schmellic/speeduino-dash/docs/speeduino_solder_points.png

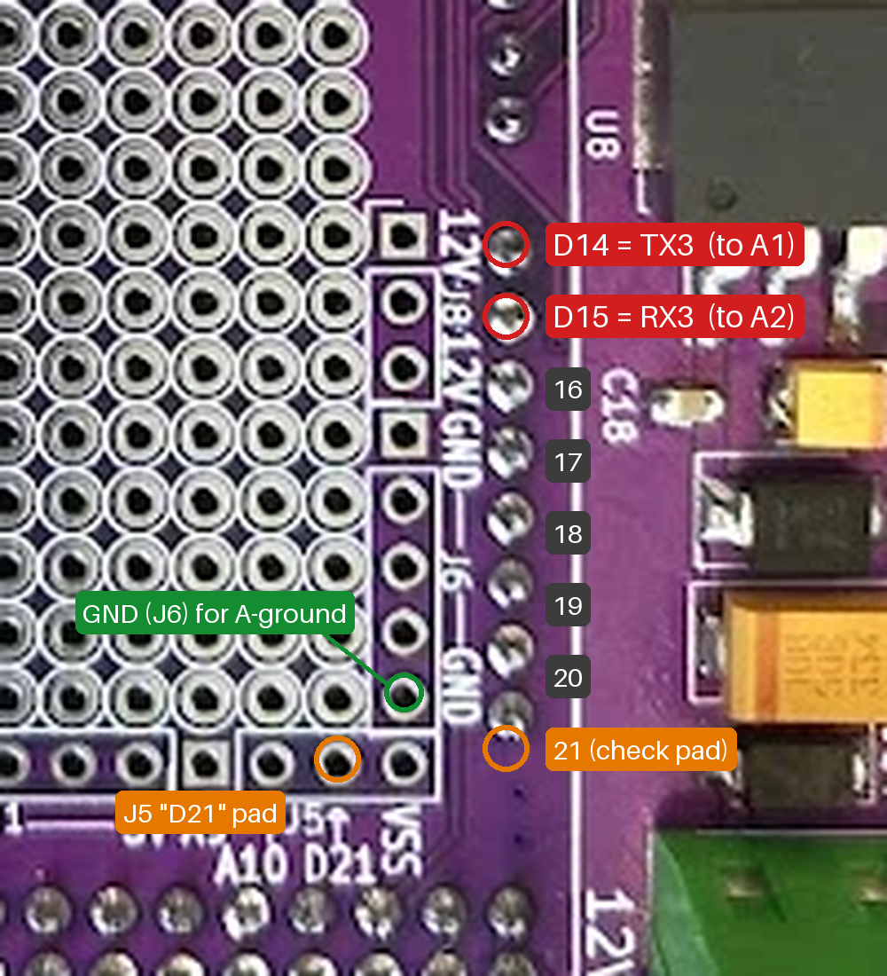
docs/speeduino_solder_points.png
