schmellic/speeduino-dash/docs/bridge_board_labelled.jpg

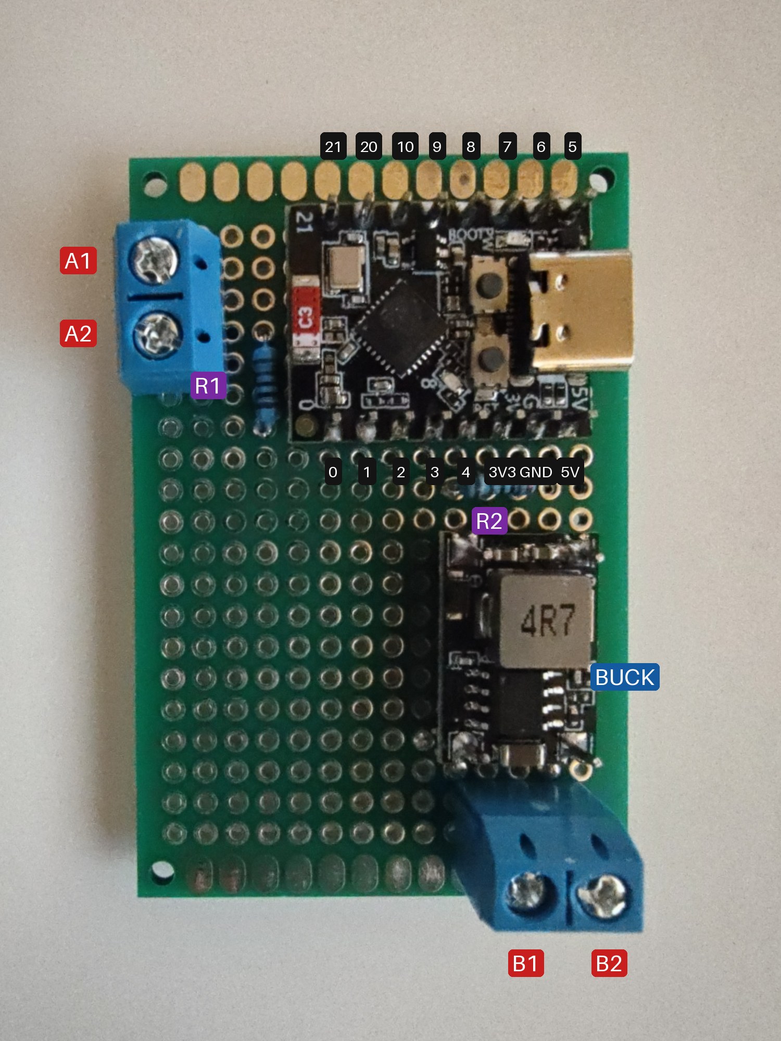
docs/bridge_board_labelled.jpg
