schmellic/speeduino-dash/docs/header_labels.pdf

Dash header labels, print at 100% (no scaling). Pitch 2.54 mm. Top = screen pin, bottom = ESP32 pin (GPIO number).

TACH

VCC 3V3

GND GND
SCL 18

SDA 23
RST 22
DC 21
CS 5
BL 25

INFO

VCC 3V3

GND GND
CS 4

RESET 27
DC 21

SDI 23

SCK 18
LED 26
