schmellic/speeduino-dash/enclosure/stl/bridge_box_lid.stl

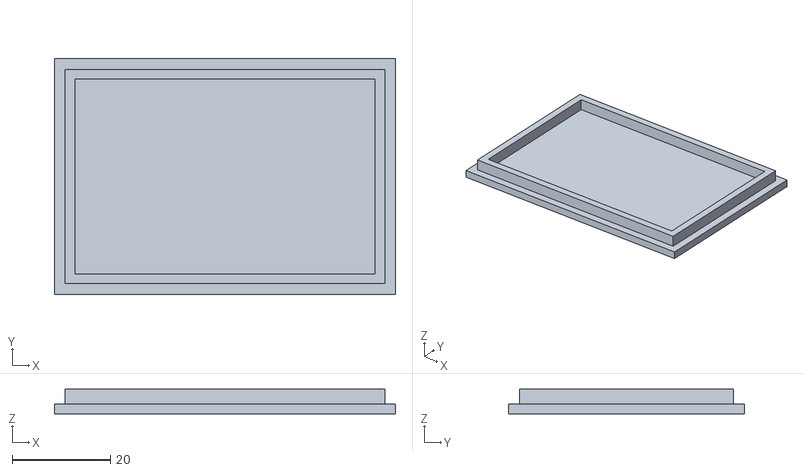
[picture p3: CAD file, 2026-11-03]
enclosure/stl/bridge_box_lid.stl
69.5 x 48.0 x 5.00
