schmellic/speeduino-dash/enclosure/stl/bridge_box_base.stl

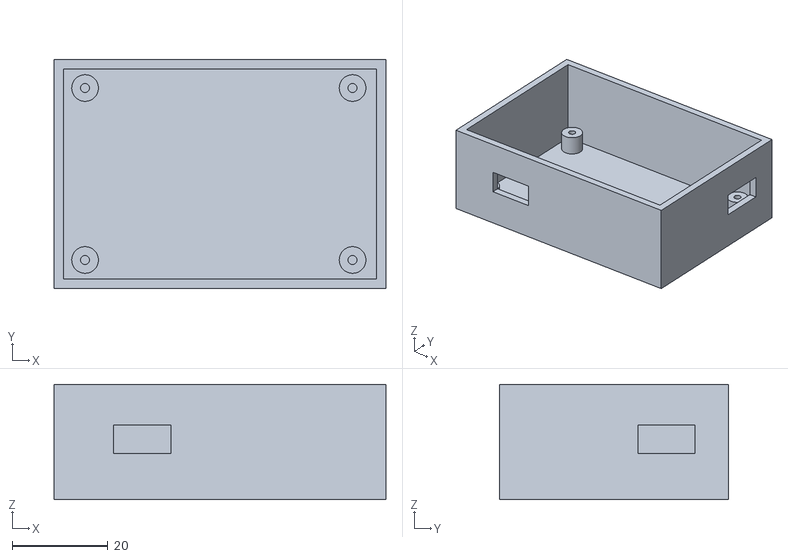
[picture p4: CAD file, 2026-11-03]
enclosure/stl/bridge_box_base.stl
69.5 x 48.0 x 24.1
