schmellic/speeduino-dash/docs/esp32_solder_pins.png

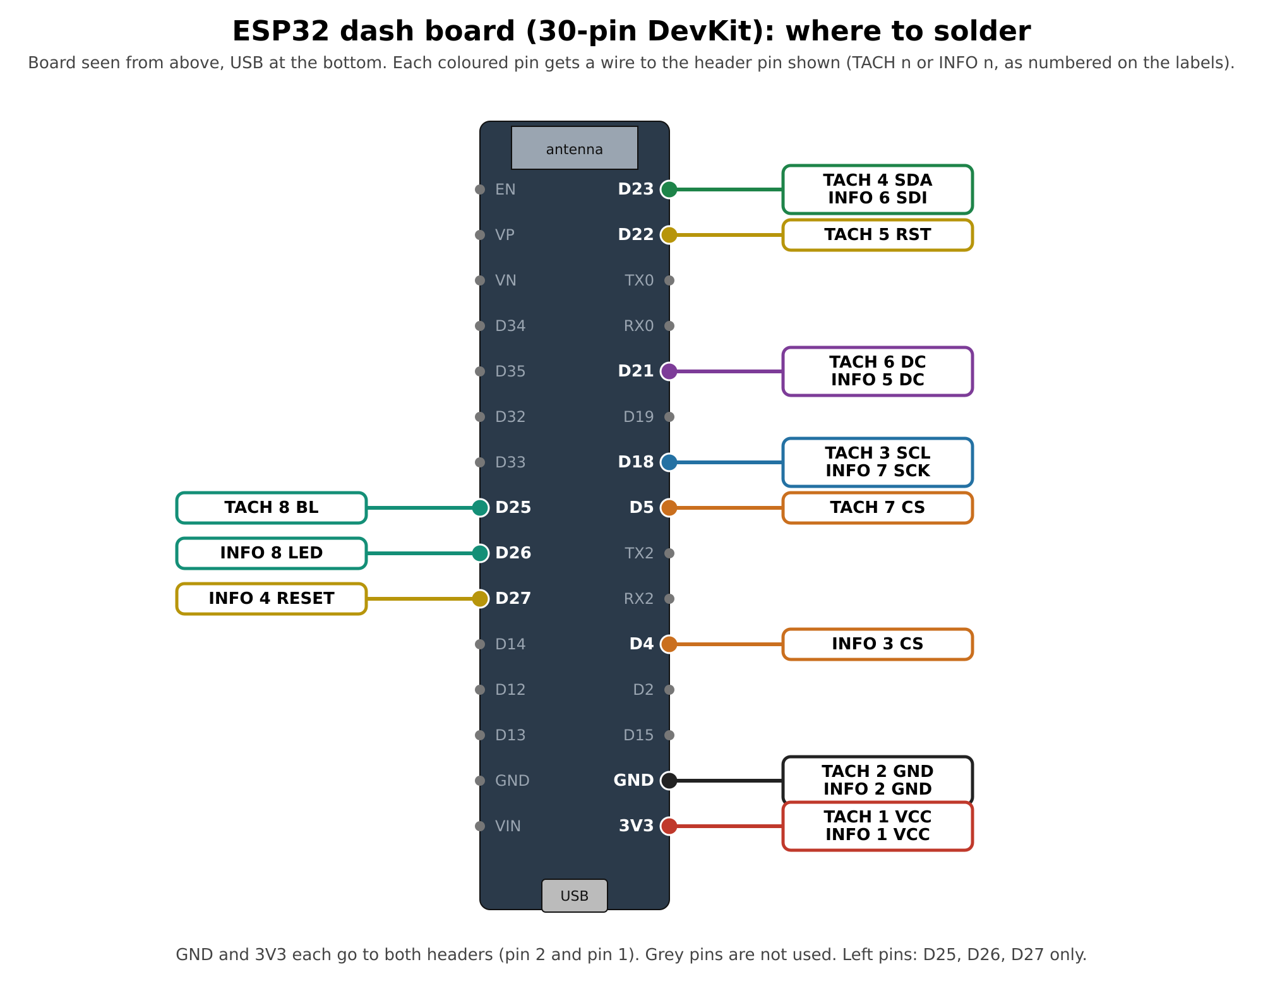
docs/esp32_solder_pins.png
