schmellic/speeduino-dash/docs/solder_diagram.png

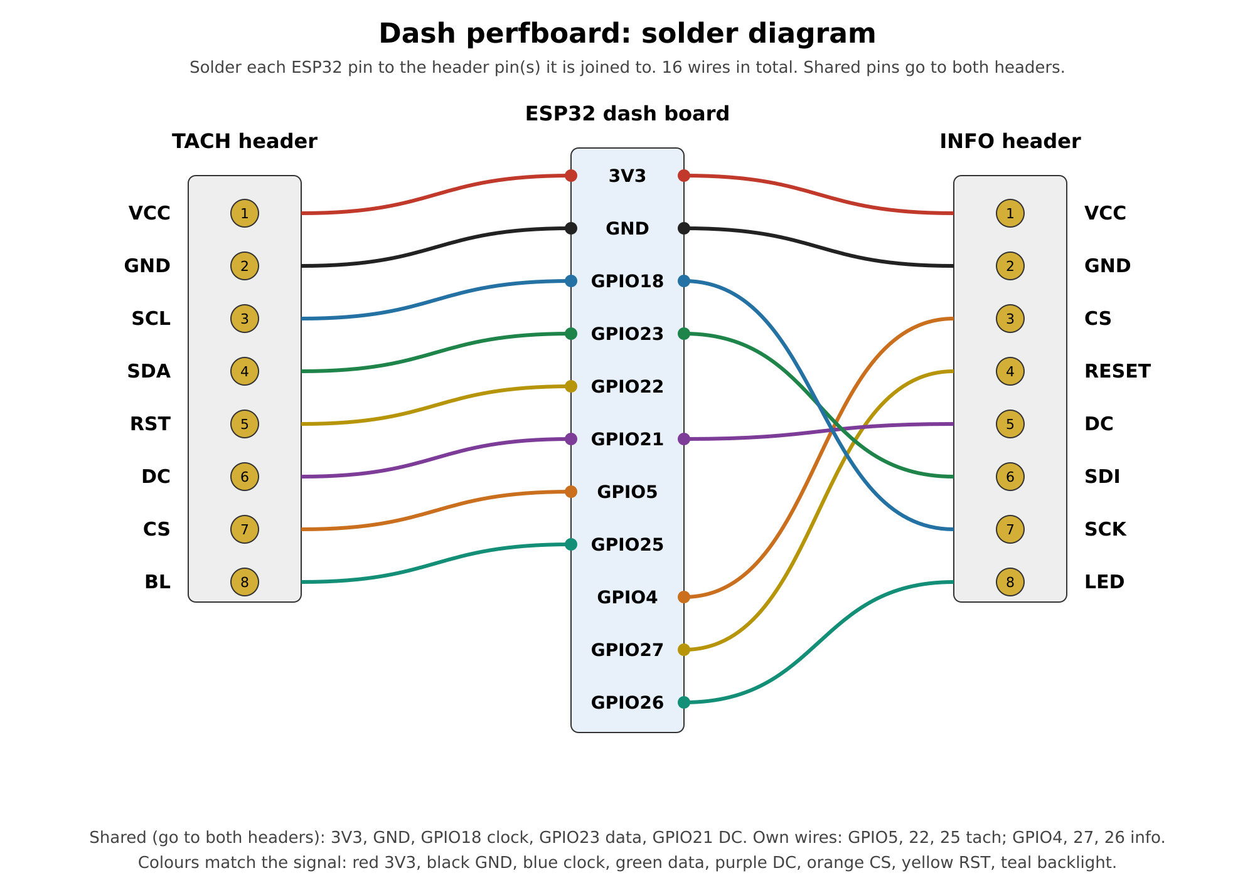
docs/solder_diagram.png
