schmellic/speeduino-dash/docs/solder_side_by_side.png

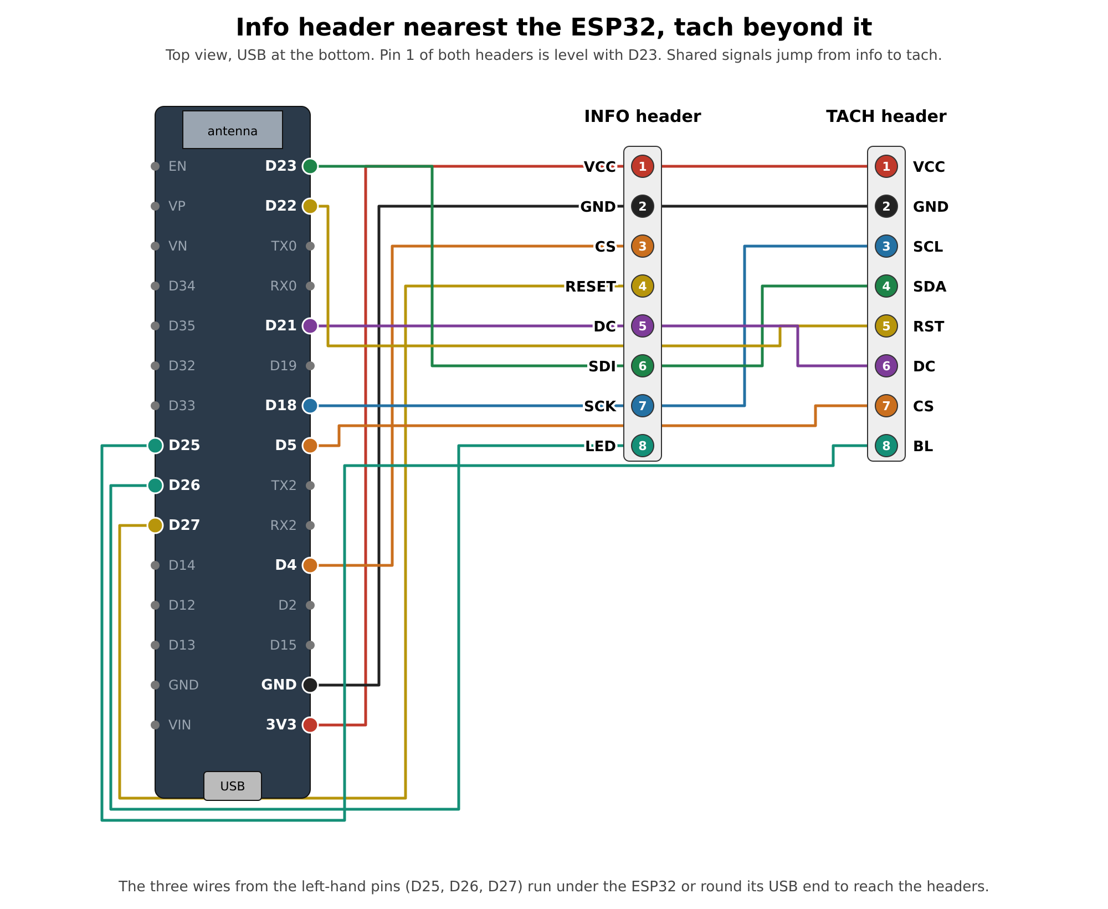
docs/solder_side_by_side.png
