schmellic/speeduino-dash/(commit log)

2026-11-02 Fix Speeduino realtime offsets and use the ini's r command
    Advance is byte 24 and TPS byte 25 per the 202402 ini; request the first
    32 bytes with the r command and tolerate an echoed 'r'.
    [main.cpp]
2026-11-02 Add bridge enclosure (Fusion script + OpenSCAD) and update notes
    [bridge_box.scad]
2026-11-02 Notes: C3 SuperMini pinout and bridge wiring
2026-11-02 Notes: bridge board 12 V terminal polarity
2026-11-02 Notes: bridge board resistor values
2026-11-02 Notes: bridge board serial terminal confirmed
2026-11-02 Notes: locate Mega TX3/RX3 holes on the v0.4.4d shield (derived)
2026-11-02 Notes: next steps are enclosure, ECU soldering and in-car link test
2026-11-02 Add wiring diagram and labelled board photos to docs/
2026-11-03 Redesign bridge enclosure around the 40x60 perfboard on standoffs
    Drop the USB/terminal access and the old OpenSCAD version, update notes.
    [bridge_box.scad]
2026-11-03 Bridge box: standoffs at the board's four 2 mm-in holes; update notes
2026-11-03 Notes: tallest part measured at 12 mm, keep COMP_H 14
2026-11-03 Add bridge box STLs; record confirmed standoff height and M2 screws
    [bridge_box_base.stl, bridge_box_lid.stl]
2026-11-03 Bridge box: tune wall thicknesses for printing, regenerate STLs
    [bridge_box_base.stl, bridge_box_lid.stl]
2026-11-03 Bridge box: wire windows at the terminal entries, 1.5 mm board; regenerate STLs
    [bridge_box_base.stl]
2026-11-03 Bridge box: terminal window positions from calipers; regenerate STLs
    [bridge_box_base.stl]
2026-11-03 Bridge box: 1.9 mm M2 pilot holes for machine screws; regenerate STLs
    [bridge_box_base.stl]
2026-11-03 Bridge box: friction-fit lid by default (screws mode kept); regenerate STLs
    [bridge_box_base.stl, bridge_box_lid.stl]
2026-11-03 Bridge box: shorten to 69.5 mm without corner posts; regenerate STLs
    [bridge_box_base.stl, bridge_box_lid.stl]
2026-11-10 Tach: scanline needle and strip eraser remove the dotted trail; add INFO_SCREEN switch
2026-11-10 Tach: dial to 6000, 50 px ring, tighter centre (user's chosen layout)
    [main.cpp]
2026-11-10 Wireless dash verified with the C3 sim bridge; sim sweeps 100-5900 rpm
2026-11-10 Notes: no-data case verified on the dash
2026-11-12 Info screen verified on shared SPI bus; dash_sim drives both screens
2026-11-12 Info screen: tach design language, eight panels incl. throttle bar and link status, fix inversion
    [main.cpp]
2026-11-12 Notes: dash mount requirements checklist
2026-11-12 Notes: dash mount location undecided
2026-11-13 Solder diagram for the dash perfboard headers
2026-11-13 ESP32 30-pin board diagram showing where each header wire is soldered
2026-11-13 Wiring diagram for headers parallel to the ESP32, pin 1 level with D23
2026-11-13 Parallel-header diagram: shared wires jump between headers
2026-11-13 Parallel-header diagram: info header nearest the ESP32, tach beyond it
